mrdving/BioInstrumentation-EOG-2022/README.md

The main documentations are stored in the pdfs : 
- Filter_Amp.pdf
    1. Filtering
    2. Amplification
- LED_Interface.pdf
    1. User interface with LEDS
    2. Peak detection
    3. Smoothing
- Sensor.pdf
    1. EOG sensor
    2. Validation dataset
- Validation.pdf
    1. Validation

Circuit Diagrams are pictures for quick referencing.
The mp4s are validation results (refer to "Validation.pdf").

Folders:
- Circuits:
    1. Backup for LTSpice circuits
- DataSet:
    1. Validation dataset
    2. Matlab code for validation
- DataSheets:
    1. DataSheets for quick reference
