mrdving/BioInstrumentation-EOG-2022/Circuit_diagram.png

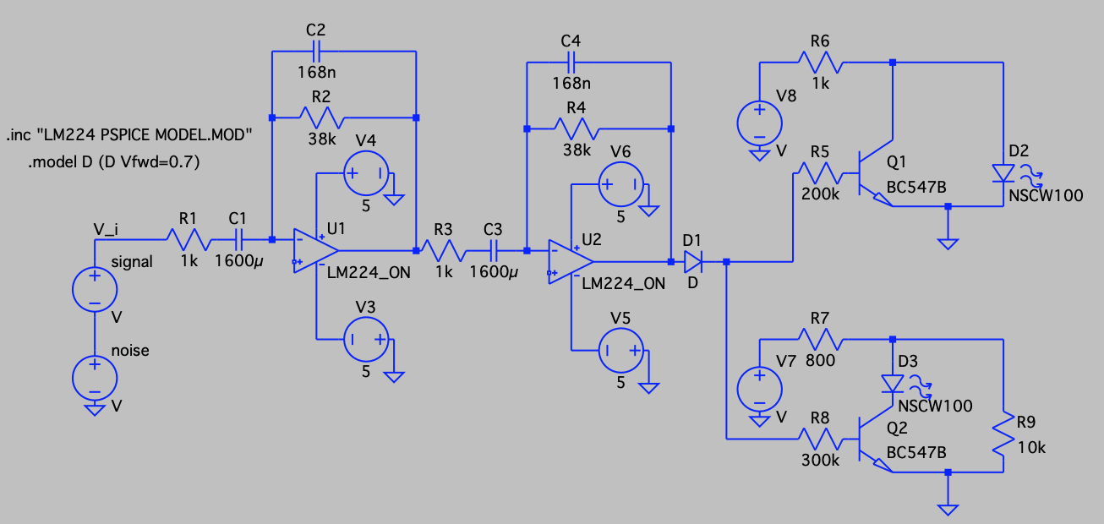
Circuit_diagram.png
