mrdving/BioInstrumentation-EOG-2022/Circuit_Diagram_FiltAmp.png

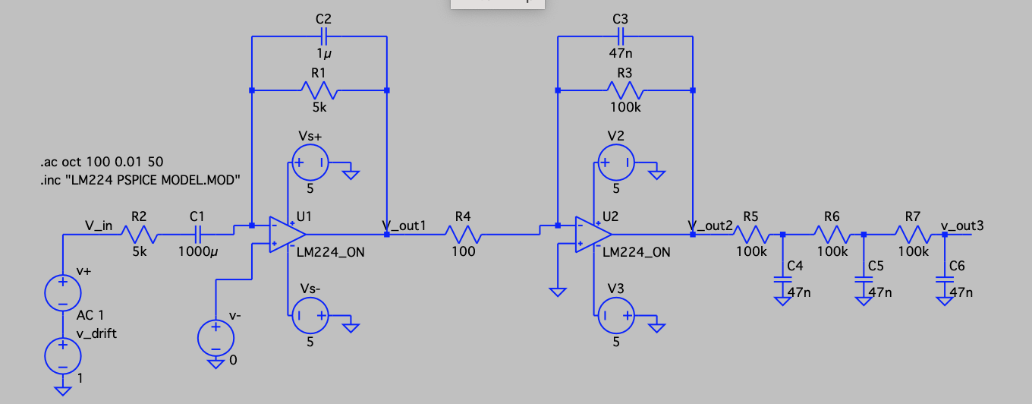
Circuit_Diagram_FiltAmp.png
