mrdving/BioInstrumentation-EOG-2022/CircuitDiagram_UI.png

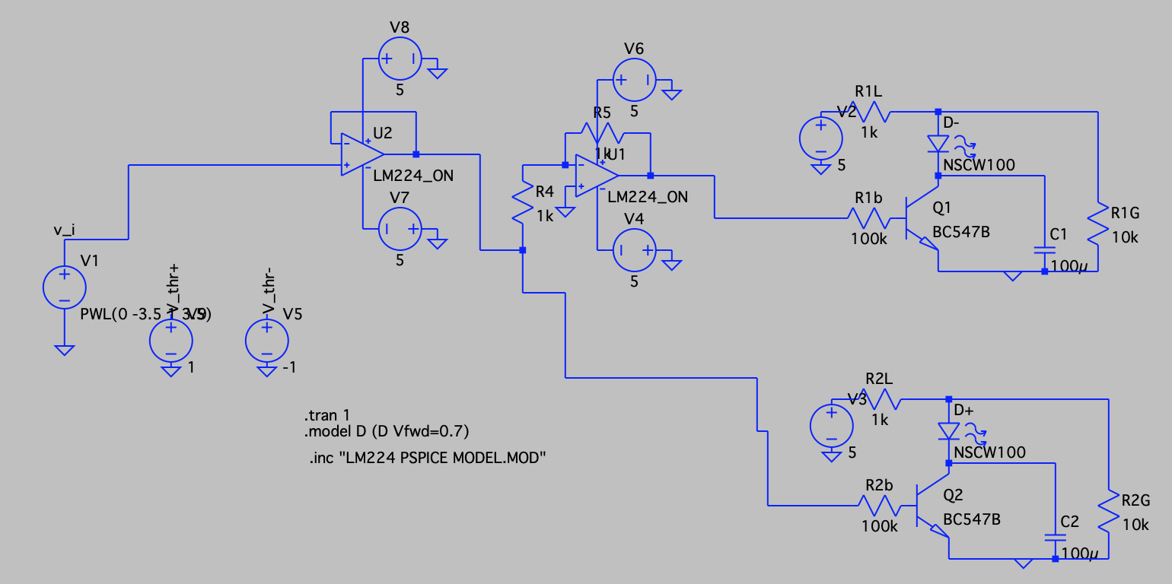
CircuitDiagram_UI.png
