mrdving/BioInstrumentation-EOG-2022/Circuits/ForQuickTesting/BasicTransistor.asc

Q1: npn; BC547B
R1: res; 1000k
R2: res; 100
V1: voltage; SINE(0 5 1)
V2: voltage; 5
Named nets: 0, V_i
.tran 1
