mrdving/BioInstrumentation-EOG-2022/Circuits/ForQuickTesting/BasicDiode.asc

D1: LED; NSCW100
R1: res; 1k
V1: voltage; SINE(0 5 1)
Named nets: 0, Vi, Vo
.tran 1
.model Value D(Vfwd=0.7)
