mrdving/BioInstrumentation-EOG-2022/Circuits/FullCircuit.asc

C1: cap; 1600µ
C2: cap; 168n
C3: cap; 1600µ
C4: cap; 168n
D1: diode
D2: LED; NSCW100
D3: LED; NSCW100
noise: voltage
Q1: npn; BC547B
Q2: npn; BC547B
R1: res; 1k
R2: res; 38k
R3: res; 1k
R4: res; 38k
R5: res; 200k
R6: res; 1k
R7: res; 800
R8: res; 300k
R9: res; 10k
signal: voltage
U1: opamp2; LM224_ON
U2: opamp2; LM224_ON
V3: voltage; 5
V4: voltage; 5
V5: voltage; 5
V6: voltage; 5
V7: voltage
V8: voltage
Named nets: 0, V_i
.model D (D Vfwd=0.7)
.inc "LM224 PSPICE MODEL.MOD"
