mrdving/BioInstrumentation-EOG-2022/(commit log)

2022-03-27 Try out the sensor, though not very successful
2022-04-05 NEW : Simulation circuit : filter + Amp
2022-04-05 NEW : Filter + Amp : component param calculation & simulation
2022-04-05 Circuit diagram : NEW : add filter & amp
2022-04-25 Created a simple LED interface for shining one at low signal voltage, and another at high signal voltage. The threshold needs better adjustments. The low signal also needs amplification.
2022-04-25 Add toDos on UI design. Sort toDos by priority. Include reminder on sensor toDos.
2022-04-25 UI : NEW : Simple circuit on the led ui. Needs improvement on threshold and amplification
2022-05-01 Replace LED_interface.pdf
2022-05-01 UI : UPDATE for a circuit that truly shines 2 LEDs at high/low signal voltage, but V_in risen to 5V
2022-05-01 UI : UPDATE circuit that shines 2 LEDs at hi/low angle
2022-05-01 Prototyping : NEW : Folder for simple circuits that quickly tests one of the components
2022-05-01 Prototyping : NEW : Circuit for confirming diode properties
2022-05-01 Prototyping : NEW : Basic circuit for determining base resistance
2022-05-06 Filt&Amp: CHANGE the filter to second order filter, and the output signal to 5V
2022-05-06 Filt&Amp : UPDATE circuit
2022-05-06 CircuitDiagram: NEW : Filter and amplifier
2022-05-06 CircuitDiagram : INTEGRATE filtamp with ui
2022-05-06 Circuit : NEW : Full circuit integrating filtamp & UI
2022-05-06 ToDo : UPDATE tasks on full circuit simulation testing
2022-05-10 FiltAmp : UPDATE circuit for ease of build, TEST with simulated signal, actual signal, and WS dataset
2022-05-10 Sensor : RENAME from project documentation to Sensor
2022-05-10 Sensor : TEST with eog sensor again(failed), introduced dataset that comes with gaze angle for future testing
2022-05-10 Circuit : UPDATE filtamp circuit for ease of build
2022-05-10 Circuit Diagram : UPDATE filtamp circuit
2022-05-10 CircuitDiagram : NEW UI
2022-05-15 Sensor : TEST with the database found, confirmed that drift is removed, and amplitude at 1.5V
2022-05-15 DataSet : NEW mirrored signal of S1 at time 10 to 20s
    [sig_1.csv]
2022-05-15 Dataset : NEW mirrored signal from S1 from 120 to 130s
    [sig_2.csv]
2022-05-15 Dataset : NEW gaze angle of signal 1
    [gaze_1.csv]
2022-05-15 Dataset : NEW gaze angle of signal 2
    [gaze_2.csv]
2022-05-15 Dataset : NEW time stamp of signal 1
    [time_1.csv]
2022-05-15 Dataset : NEW time stamp of signal 2
    [time_2.csv]
2022-05-15 ToDo : NEW Tasks for peak detector, generated by the findings in sensor signal. We need a threshold crossing detector and hold the signal for a period of time
2022-05-17 FilteAmp : CHANGEd the filter component to unity gain. Did not resolve the lower gain issue. Threshold set for 1V
2022-05-17 CircuitDiagram : UPDATE filtamp to unity gain bpf
2022-05-17 Circuit : Update FiltAmp to unity gain bpf
2022-05-17 UI : ADD voltage follower, CHANGE threshold, TEST in circuit
2022-05-17 CircuitDiagram : UI Update
2022-05-17 Circuit : UI UPDATE
2022-05-17 ToDo : COMPLETE UI & peak detector requirements, ADD tasks in validation & design report, SURFACE calibration tasks
2022-05-18 UI : RESOLVED issue, the components are fine, the issue stems from LED itself
2022-05-18 FiltAmp : ADD low pass filter to the tail, CHANGE capacitance
2022-05-18 UI : CHANGE smoothing capacitor to reduce flickering when testing with noisy data
2022-05-18 ToDo : COMPLETE consultation, DISCARD sensor related tasks, COMPLETE validation documentation, ADD validation tasks on new circuit
2022-05-22 CircuitDiagram : UPDATE UI Circuit
2022-05-22 CircuitDiagram : UPDATE Filtamp Circuit
